hazenluk/SSI2131_Eurorack_Breakout/README.md

# SSI2131_Eurorack_Breakout
Single PCB Eurorack Module for SSI2131. Potentiometers and jacks are mounted to the backside of the PCB, which also serves as the front of the module.

Board Front
Board Front
