hazenluk/SSI2131_Eurorack_Breakout/ssi2131_ref.kicad_pcb

## KiCad design ssi2131_ref.kicad_pcb (2023-09-28)

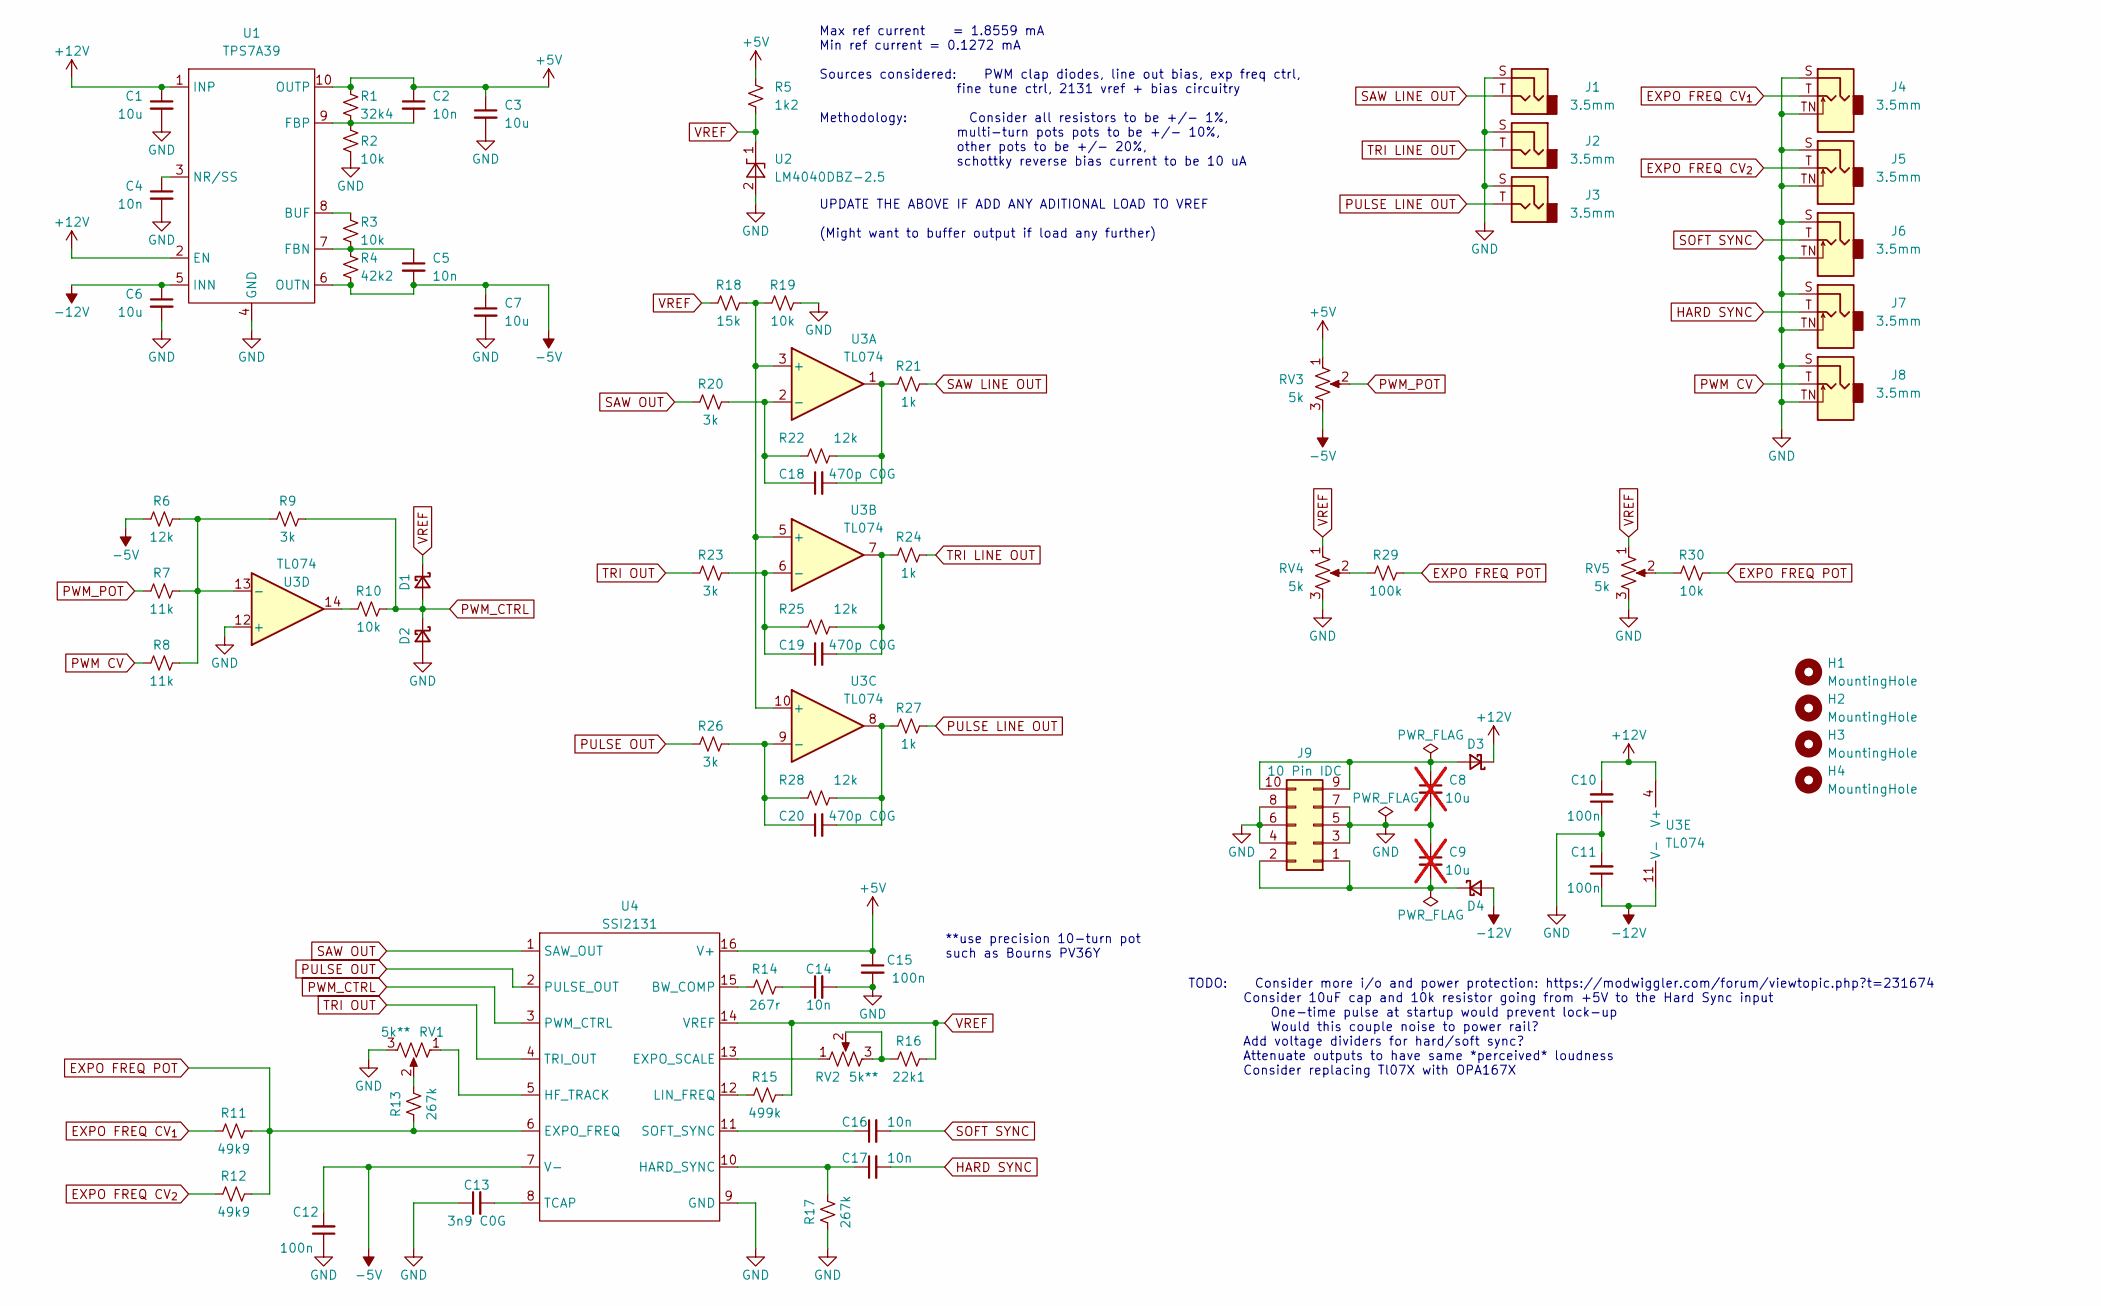
[picture p1: schematic ssi2131_ref.kicad_sch, SSI2131 Reference]

Parts:
C1, C3, C6, C7: 10u; C_0603_1608Metric
C2, C4, C5, C14, C16, C17: 10n; C_0402_1005Metric
C8, C9: 10u; C_0603_1608Metric; not fitted
C10, C11, C12, C15: 100n; C_0402_1005Metric
C13: 3n9 C0G; C_0603_1608Metric
C18, C19, C20: 470p C0G; C_0402_1005Metric
D1, D2, D3, D4: D_Schottky_Small; D_SOD-323
H1, H2, H3, H4: MountingHole; MountingHole_3.2mm_M3
J1, J2, J3: 3.5mm; PJ-301BM
J4, J5, J6, J7, J8: 3.5mm; PJ-301BM_disconnect
J9: 10 Pin IDC; IDC-Header_2x05_P2.54mm_Vertical_SMD
R1: 32k4; R_0402_1005Metric
R2, R3, R10, R19, R30: 10k; R_0402_1005Metric
R4: 42k2; R_0402_1005Metric
R5: 1k2; R_0402_1005Metric
R6, R22, R25, R28: 12k; R_0402_1005Metric
R7, R8: 11k; R_0603_1608Metric
R9, R20, R23, R26: 3k; R_0603_1608Metric
R11, R12: 49k9; R_0402_1005Metric
R13, R17: 267k; R_0402_1005Metric
R14: 267r; R_0402_1005Metric
R15: 499k; R_0402_1005Metric
R16: 22k1; R_0402_1005Metric
R18: 15k; R_0402_1005Metric
R21, R24, R27: 1k; R_0402_1005Metric
R29: 100k; R_0402_1005Metric
RV1, RV2: 5k**; Potentiometer_Bourns_3224W_Vertical
RV3, RV4, RV5: 5k; Potentiometer_Alpha_RD901F-40-00D_Single_Vertical_Bodge
U1: TPS7A39; Texas_DSC0010J
U2: LM4040DBZ-2.5; SOT-23
U3: TL074; TSSOP-14_4.4x5mm_P0.65mm
U4: SSI2131; SOP-16_4.55x10.3mm_P1.27mm

Connections:
+5V: C2.1, C3.1, C15.1, R1.1, R5.1, RV3.1, U1.10 (OUTP), U4.16 (V+)
+12V: C1.1, C10.2, D3.1 (K), U1.1 (INP), U1.2 (EN), U3.4 (V+)
-5V: C5.2, C7.1, C12.2, R4.2, R6.1, RV3.3, U1.6 (OUTN), U4.7 (V-)
-12V: C6.1, C11.1, D4.2 (A), U1.5 (INN), U3.11 (V-)
EXPO FREQ CV_{1}: J4.T, R11.1
EXPO FREQ CV_{2}: J5.T, R12.1
EXPO FREQ POT: R11.2, R12.2, R13.1, R29.2, R30.2, U4.6 (EXPO_FREQ)
GND: C1.2, C3.2, C4.2, C6.2, C7.2, C8.2, C9.1, C10.1, C11.2, C12.1, C13.1, C14.2, C15.2, D2.2 (A), J1.S, J2.S, J3.S, J4.S, J4.TN, J5.S, J5.TN, J6.S, J6.TN, J7.S, J7.TN, J8.S, J8.TN, J9.3, J9.4, J9.5, J9.6, J9.7, J9.8, R2.2, R17.1, R19.2, RV1.3, RV4.3, RV5.3, U1.4 (GND), U1.11 (GND), U2.2 (A), U3.12 (+), U4.9 (GND)
HARD SYNC: C17.2, J7.T
unnamed: C14.1, R14.2
unnamed: C18.2, R21.1, R22.2, U3.1
unnamed: C19.2, R24.1, R25.2, U3.7
unnamed: C20.2, R27.1, R28.2, U3.8
unnamed: C8.1, D3.2 (A), J9.9, J9.10
unnamed: C9.2, D4.1 (K), J9.1, J9.2
unnamed: R10.1, U3.14
unnamed: R13.2, RV1.2
unnamed: R16.1, RV2.2, RV2.3
unnamed: R29.1, RV4.2
unnamed: R30.1, RV5.2
unnamed: R3.1, U1.8 (BUF)
unnamed: C5.1, R3.2, R4.1, U1.7 (FBN)
unnamed: C2.2, R1.2, R2.1, U1.9 (FBP)
unnamed: C4.1, U1.3 (NR/SS)
unnamed: R18.2, R19.1, U3.3 (+), U3.5 (+), U3.10 (+)
unnamed: C18.1, R20.2, R22.1, U3.2 (-)
unnamed: C19.1, R23.2, R25.1, U3.6 (-)
unnamed: C20.1, R26.2, R28.1, U3.9 (-)
unnamed: R6.2, R7.2, R8.2, R9.1, U3.13 (-)
unnamed: R14.1, U4.15 (BW_COMP)
unnamed: RV2.1, U4.13 (EXPO_SCALE)
unnamed: C17.1, R17.2, U4.10 (HARD_SYNC)
unnamed: RV1.1, U4.5 (HF_TRACK)
unnamed: R15.1, U4.12 (LIN_FREQ)
unnamed: C16.1, U4.11 (SOFT_SYNC)
unnamed: C13.2, U4.8 (TCAP)
PULSE LINE OUT: J3.T, R27.2
PULSE OUT: R26.1, U4.2 (PULSE_OUT)
PWM CV: J8.T, R8.1
PWM_CTRL: D1.2 (A), D2.1 (K), R9.2, R10.2, U4.3 (PWM_CTRL)
PWM_POT: R7.1, RV3.2
SAW LINE OUT: J1.T, R21.2
SAW OUT: R20.1, U4.1 (SAW_OUT)
SOFT SYNC: C16.2, J6.T
TRI LINE OUT: J2.T, R24.2
TRI OUT: R23.1, U4.4 (TRI_OUT)
VREF: D1.1 (K), R5.2, R15.2, R16.2, R18.1, RV4.1, RV5.1, U2.1 (K), U4.14 (VREF)

Notes on the sheet:
**use precision 10-turn pot such as Bourns PV36Y
UPDATE THE ABOVE IF ADD ANY ADITIONAL LOAD TO VREF (Might want to buffer output if load any further)
Max ref current = 1.8559 mA Min ref current = 0.1272 mA Sources considered: PWM clap diodes, line out bias, exp freq ctrl, fine tune ctrl, 2131 vref + bias circuitry Methodology: Consider all resistors to be +/- 1%, multi-turn pots pots to be +/- 10%, other pots to be +/- 20%, schottky reverse bias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
TODO: Consider more i/o and power protection: https://modwiggler.com/forum/viewtopic.php?t=231674 Consider 10uF cap and 10k resistor going from +5V to the Hard Sync input One-time pulse at startup would prevent lock-up Would this couple noise to power rail? Add voltage dividers for hard/soft sync? 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

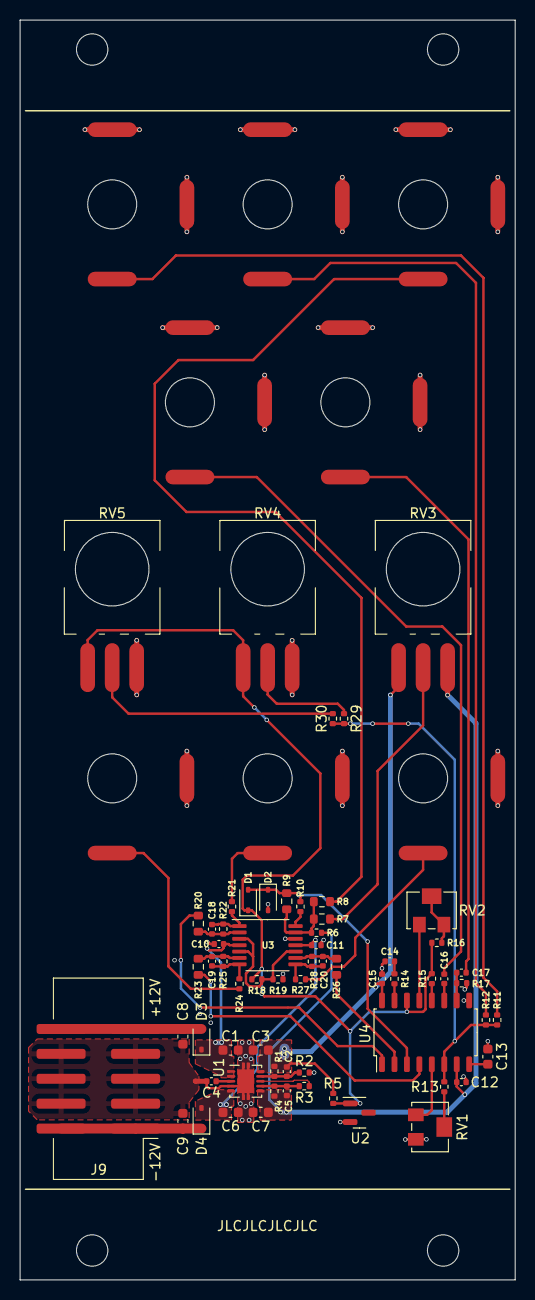
[picture p2: board ssi2131_ref.kicad_pcb from above]

Board: 4 copper layers, 50.5 x 128.5 mm, 76 parts (0 on the bottom side), 47 nets.
