hazenluk/SSI2131_Eurorack_Breakout/(commit log)

2023-09-28 Upload to github
    [BOM-ssi2131_ref.csv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]
2023-09-28 Clened repo; stopped tracking backup files
    [ssi2131_ref_op_amp_current_clamp.kicad_sch]
2023-09-28 Added board images
